CRETATECH/CRETA-WiSock/3_Document/Wisock_Design.pdf

# DETAILED DESIGN DOCUMENT

# for

# WiSocket

## Version 1.0

## Prepared by HgN

## CRETA Solution Company

## September 22, 2017

1

# Contents

1 Introduction and Goals | 3
2 Design Constrains | 4
3 Design Overview | 5
4 Environment and Dependencies | 9
5 API specification | 10
6 Unit test | 12

2

# 1 Introduction and Goals

## 1.1 Introduction

This document introduce the key idea of WiSocket. Its intended audience comprises Developers and Testers who need a rough understanding on the concepts of the module.

The document describes the component and its internal logic, lists any dependencies to external components, internal constraints and defines its APIs.

The document explains the components design in detail.

## 1.2 Goals

The main goals of this product is:

1. WiSocket can control one device via both button or app.
2. WiSocket’s WiFi can be setup easily using SmartConfig.

## 1.3 Definitions, Acronyms and Abbreviations

MQTT | Message Queuing Telemetry Transport
MAC | Media Access Controll Address

## 1.4 Referenced Document

HW Schematic | 1 Input/WiSocket Schematic.pdf
Detailed requirement | 1 Input/WiSocket Requirement.pdf

3

# 2 Design Constrains

1. Product must have a status led that show product status clearly, easy.
2. Control/Config method should be simple and convinient for non-tech user.
3. All devices and leds must be active-low.

4

# 3 Design Overview

## 3.1 Overview

1. General:
- This product has:

– 1 device which can be controlled ON/OFF via digital sysnal.

– 1 config button (push button), use polling method.

– 1 control button (switch), use interrupt.

– 1 status led.

- All devices and leds must be active-low.
- Status led can show: WiFi Connecting, WiFi Connected and WiFi Configur-ing.
- Firmware has two state: Config and Control.
- User can go in and out state Config by holding config button for about 3 seconds.
- User can control device via control button at anytime, even without internet.
2. State Config:
- Use SmartConfig to setup device’s WiFi.
- An config flag stored in EEPROM at address 0x10. This flag must be read each time start up to check WiFi configuration.

– Value 0x05: Device is already configured. Try to connect using saved SSID and password.

– Other value: Deive has no SSID and password to connect.

3. State Control:

5

- Device try to connect to WiFi and MQTT server. Always check for proper connection. Should have connection failure hanlder.
- Topic name:
Topic to subcribe | ESP+<MAC>/master
Topic to publish | ESP+<MAC>/slave
- Use protocol as in Requirement Documentation (5.3.2 Data Format) to com-municate with user’s app. There’s 2 function:

– Function Control: Control 1 device ON/OFF.

– Function Data: Get status of device.

## 3.2 Configuration

These parameters should be setup manually in firmware: MQTT server ”iot.eclipse.org”

## 3.3 File structure

WiSocket.ino
|___state.h
|___protocol.h
| |___mqtt.h
|___device.h
|___button.h

## 3.4 Critical timing constrains

- All function must have execute time within 1s to prevent ESP watchdog timer reset.

6

## 3.5 Diagram

### 3.5.1 State machine

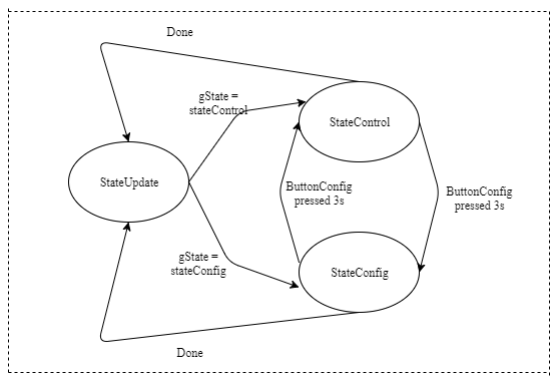
[picture p1: figure]

Figure 3.1: WiSocket’s state machine

### 3.5.2 State Config and Control

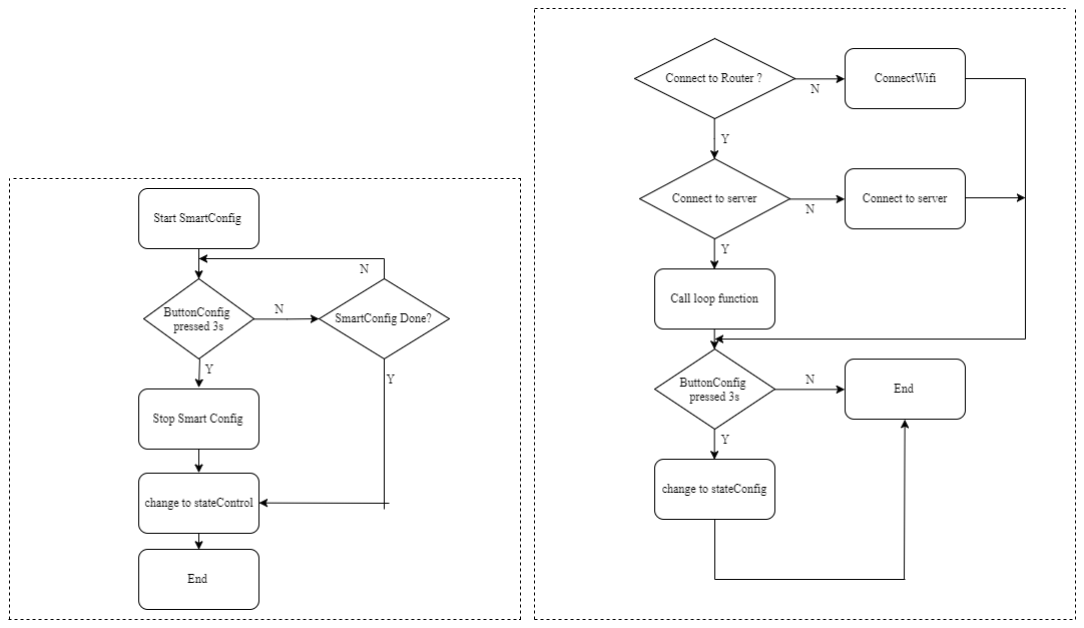
[picture p2: figure]

(a) State Config | (b) State Control

Figure 3.2: WiSocket’s state config and control

7

## 3.6 Failure handling strategy

- All conditional loops must have time out condition to prevent hanging.

8

# 4 Environment and Dependencies

## 4.1 Evironment

This project is built using Arduino IDE 1.8.4.

## 4.2 Dependencies

This project need these dependencies:

- Board packet: esp8266 by ESP8266 Community version 2.2.0.
- Library: ArduinoJson by Benoit Blanchon version 5.5.1.
- Library: PubSubClient by Nick O’Leary version 2.6.0.

9

# 5 API specification

## 5.1 Device

v oid d e v i c e I n i t ( v oid ) ;
v oid deviceOn ( v oid ) ;
v oid d e vi c e O f f ( v oid ) ;
v oid d e vi c eT o g gl e ( v oid ) ; v oid ledDeviceOn ( v oid ) ; v oid l e dD e vi c eO f f ( v oid ) ; v oid ledWi fiOn ( v oid ) ;
v oid l e dWi fi O f f ( v oid ) ;
v oid l e dWi fi T o g gl e ( v oid ) ; i n t d e vi c e S t a t u s ( v oid ) ;

## 5.2 Button

v oid b u t t o n I ni t ( v oid ) ; | [ ESP PJ 0 1 8]
v oid bu t tonCon fig ISRHandle r ( v oid ) ; | [ ESP PJ 0 2 0]
b o ol buttonCon figCheck ( v oid ) ; | [ ESP PJ 0 1 9 , 0 0 8]
b o ol buttonControlCheck ( v oid ) ; | [ ESP PJ 0 2 0]

## 5.3 MQTT

v oid c a l l b a c k ( ch a r ∗ t o pi c , byte ∗ payload , un si gned i n t l e n g t h ) ;
| [ ESP PJ 014−017]
v oid mqttCreateTopic ( v oid ) ; | [ ESP PJ 022−023]
v oid m q t tSub sc ribe ( v oid ) ; | [ ESP PJ 0 2 1]
i n t mqttConnect ( v oid ) ; | [ ESP PJ 0 2 1]
i n t mqttConnected ( v oid ) ; | [ ESP PJ 0 2 1]
v oid mq t tPublish ( S t ri n g jsonOut ) ; | [ ESP PJ 0 2 1]
v oid mqttLoop ( v oid ) ; | [ ESP PJ 0 1 3]

10

## 5.4 Protocol

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

## 5.5 State

v oid s t a t e S e t u p ( v oid ) ; | [ ESP PJ 006−007]
v oid s t a t e C o n fi g ( v oid ) ; | [ ESP PJ 0 0 5 , 033−037]
v oid s t a t e C o n t r ol ( v oid ) ; | [ ESP PJ 009−12]

11

# 6 Unit test

12
