CRETATECH/CRETA-WiSock/3_Document/WiSock_test.pdf

## TÀI LIỆU KIỂM TRA ĐÁNH GIÁ

## Dự án: WiSock

Soạn thảo: HgN + Nghia

Ngày 1 tháng 10 năm 2017

## Mục lục

1 GIỚI THIỆU | 3
2 PHƯƠNG THỨC HOẠT ĐỘNG VÀ CÁC YẾU TỐ CẦN KIỂM TRA | 4
3 Chi tiết phương thức kiểm tra đánh giá | 5
4 PHỤ LỤC | 7

1 | GIỚI THIỆU
1.1 | Giới thiệu

Tài liệu này được soạn nhằm liệt kê các công cụ và phương thức kiểm tra sản phẩm. Cụ thể tài liệu sẽ liệt kê chi tiết các trường hợp cần kiểm tra, cách thức kiểm tra và đánh giá kết quả. Đối tượng của tài liệu này là các Developer và Tester tham gia vào quá trình hoàn thiện, kiểm tra và phát triển sản phẩm.

1.2 Tổng quan sản phẩm

WiSock là sản phẩm thông minh điều khiển bật tắt một thiết bị từ xa thông qua hệ thống mạng Internet. Cụ thể thiết bị sử dụng một ESP8266 v7 kết nối bằng giao thức MQTT tới một server, thông qua đó người dùng có thể điều khiển và thu thập trạng thái thiết bị thông qua ứng dụng được cung cấp.

1.3 | Các định nghĩa và viết tắt
Định nghĩa/Viết tắt | Chi tiết
WiSock | Sử dụng để nói chung sản phẩm/bộ phận điều khiển chính của sản phẩm.
Thiết bị | Nói đến thiết bị người dùng được WiSock điều khiển bật tắt.
MQTT | Message Queuing Telemetry Transport.
Topic/Broker/Subcribe/Publish | Các thuật ngữ của giao thức MQTT.
MAC | Media Access Control address.
SSID/Password | Tên và mật khẩu kết nối WiFi.
Config | Thiết lập SSID và password cho WiSock.

Bảng 1: Bảng định nghĩa và viết tắt

2 | PHƯƠNG THỨC HOẠT ĐỘNG VÀ CÁC YẾU TỐ CẦN KIỂM TRA
2.1 | Tổng quan thiết kế
1. Sau khi khởi động, WiSock sẽ kiểm tra thông tin WiFi:
| • Nếu đã có SSID và password được lưu, WiSock sẽ sử dụng thông tin đó để kết nối WiFi. • Nếu chưa có SSID và password, nhấn nút Config sẽ chuyển sang chế độ config, sử dụng giao thức SmartConfig để cài đặt SSID và password cho WiSock/
2. Sau khi kết nối WiFi thành công, WiSock sẽ cố gắng kết nối đến broker MQTT.
3. Sau khi kết nối thành công tới broker MQTT, WiSock sẽ dựa trên MAC để tạo ra các topic:
| • Topic để Subcribe: ESP+<MAC>/master • Topic để Publish: ESP+<MAC>/slave
4. WiSock lúc này có thể nhận gói tin điều khiển từ server (gói tin theo cấu trúc JSON).
5. WiSock luôn có thể được điều khiển bằng một nút nhấn (dạng switch).
6. WiSock có thể chuyển về chế độ config để thay đổi SSID và password, cũng như chuyển từ chế độ
| config về chế độ điều khiển bằng một nút nhấn (dạng push button, giữ trong 3s).
7. WiSock có một led báo trạng thái, luôn thể hiện rõ ràng trạng thái hiện tại của WiSock (WiFi
| connecting, WiFi connected, WiFi configuring).
2.2 | Các yếu tố cần kiểm tra và đánh giá
1. Kiểm tra các yếu tố phần cứng
| • Kiểm tra led trạng thái. • Kiểm tra nút nhấn điều khiển và khả năng điều khiển thiết bị. • Kiểm tra nút nhấn config.
2. Kiểm tra kết nối
| • Kiểm tra phương thức SmartConfig. • Kiểm tra kết nối tới WiFi. • Kiểm tra kết nối tới broker MQTT.
3. Kiểm tra phương thức giao tiếp
| • Kiểm tra đáp ứng của hệ thống với từng lệnh điều khiển khác nhau.
4. Kiểm tra tính ổn định của hệ thống
| • Kiểm tra khả năng xử lý của hệ thống khi mất kết nối tới WiFi hoặc broker. • Kiểm tra khả năng xử lý của hệ thống khi gặp xự cố mất điện. • Kiểm tra tính ổn đinh/đáng tin cậy của hệ thống khi hoạt động trong thời gian dài.

3 | Chi tiết phương thức kiểm tra đánh giá
3.1 | Công cụ kiểm tra
- Kiểm tra bằng tay:
| – App SmartConfig (thiết lập SSID và password). – MQTT Lens (giao tiếp với WiSock).
- Kiểm tra tự động:
| – Script python/bash và các file log.

Ngoài ra source code của WiSock có hỗ trợ debug qua cổng Serial nên có thể thể dùng thêm 1 USB UART để hỗ trợ quá trình kiểm tra sửa lỗi.

3.2 Chi tiết kiểm tra

Các phương thức kiểm tra dưới đây nên được thực hiện theo đúng trình tự từ trên xuống dưới. Một số phướng thức kiểm tra được nêu sau có thể mặc định các bài kiểm tra trước đó đã qua (pass) và dựa vào đó để đưa ra kết luận đánh giá.

3.2.1 Kiểm tra yếu tố phần cứng

Kiểm tra

- Đảm bảo WiSock được cấp nguồn đúng chuẩn và ổn định.
- Đánh giá bằng mắt hành vi của led trạng thái, đảm bảo hành vi tương tự như trong thiết kế. Từ
| đó có thể một phần dựa vào led trạng thái để đánh giá các hành vi khác.
- Bật tắt nút điều khiển và xem trạng thái của thiết bị được điều khiển.
- Nhấn giữ nút config trong khoảng 3 giây để đổi trạng thái hoạt động của WiSock.

Kết quả mong muốn

- Hệ thống khởi động nhanh, ổn định.
- Thiết bị đổi trạng thái bật tắt theo trạng thái nút nhấn, độ trễ thấp.
- WiSock chuyển đổi giữa trạng thái config và trạng thái điều khiển dễ dàng (dựa vào led trạng thái
| để kiểm tra).
3.2.2 | Kiểm tra kết nối

Kiểm tra 1: Chuyển WiSock về chế độ config, sử dụng SmartConfig để cung cấp chính xác SSID và password.

Kết quả mong muốn 1: Led trạng thái phải báo WiSock chuyển sang đang kết nối WiFi và sau đó là kết nối thành công. Ứng dụng smart config phải nhận được MAC của WiSock.

Kiểm tra 2: Kiểm tra topic "topicTest" trên MQTT ngay sau khi WiSock đã kết nối được WiFi.

Kết quả mong muốn 2: Nếu kết nối được tới broker MQTT, WiSock sẽ gửi gói tin dạng ESP+<MAC> như một dạng thông báo tên topic.

3.2.3 Kiểm tra phương thức giao tiếp

Kiểm tra 1: Lệnh điều khiển
Gửi một trong hai frame sau tới topic mà WiSock subcribe (topic master): {ID:"ESP+<MAC>", FUNC:"Ctrl", ADDR:"1", DATA:"ON"} {ID:"ESP+<MAC>", FUNC:"Ctrl", ADDR:"1", DATA:"OFF"}

Kết quả mong muốn 1:

- Thiết bị phải được bật hoặc tắt tương ứng với lệnh gửi đi.
- Nhận được trên topic mà WiSock publish (topic slave) frame sau, ứng với trạng thái sau khi điều khiển:
{ID:"ESP+<MAC>", FUNC:"Ctrl", ADDR:"1", DATA:"ON"}
{ID:"ESP+<MAC>", FUNC:"Ctrl", ADDR:"1", DATA:"OFF"}

Kiểm tra 2: Lệnh dữ liệu
Gửi frame sau tới topic mà WiSock subcribe (topic master):
{ID:"ESP+<MAC>", FUNC:"Data", ADDR:"1", DATA:""}

Kết quả mong muốn 2: Nhận được trên topic mà WiSock publish (topic slave) frame sau, ứng với trạng thái hiện tại của thiết bị:
{ID:"ESP+<MAC>", FUNC:"Data", ADDR:"1", DATA:"ON"}
{ID:"ESP+<MAC>", FUNC:"Data", ADDR:"1", DATA:"OFF"}

Kiểm tra 3: Điều khiển nút nhấn
Nhấn nút điều khiển để đổi trạng thái thiết bị.

Kết quả mong muốn 2: Nhận được trên topic mà WiSock publish (topic slave) frame sau, ứng với trạng thái hiện tại của thiết bị:
{ID:"ESP+<MAC>", FUNC:"Data", ADDR:"1", DATA:"ON"}
{ID:"ESP+<MAC>", FUNC:"Data", ADDR:"1", DATA:"OFF"}

Kiểm tra 4: Lỗi giao tiếp
Gửi một frame sai cấu trúc JSON hoặc một frame sai các trường/dữ liệu.

Kết quả mong muốn 4: Nhận được trên topic mà WiSock publish (topic slave) frame sau, ứng với trạng thái hiện tại của thiết bị:
{ID:"ESP+<MAC>", FUNC:"Error", ADDR:"1", DATA:"ErrFrame"}

3.2.4 Kiểm tra tính ổn định của hệ thống

Kiểm tra 1: Ngắt nguồn của WiSock, sau đó cấp nguồn trở lại.

Kết quả mong muốn 1: WiSock nhanh chóng khởi động, sử dụng SSID và password đã lưu để kết nối lại mà không cần phải config lại.

Kiểm tra 2: Ngắt kết nối WiFi, sau đó bật trở lại.

Kết quả mong muốn 2: WiSock báo trạng thái mất kết nối/thử kết nối lại thông qua led trạng thái. WiSock cũng phải nhanh chóng kết nối lại ngay sau khi WiFi được hồi phục (kiểm tra giống như 3.2.2).

Kiểm tra 3: Cho WiSock chạy trong thời gian dài. Trong thời gian đó liên tục gửi các gói lệnh tới WiSock để kiểm tra khả năng đáp ứng.

Kết quả mong muốn 3: WiSock hoạt động ổn định, không gặp tình trạng tự reset, ngắt kết nối, treo cứng ngưng hoạt động. Số gói tin gửi nhận thành công trên 90%.

4 | PHỤ LỤC
4.1 | Tài liệu tham khảo
Tài liệu | Nguồn
Requirement | 1_Requirement/WiSock_Requirement.pdf
HW Schematic | 1_Requirement/WiSock_Schematic.pdf
Design document | 3_Documentation/WiSock_Design.pdf

Bảng 2: Các tài liệu tham khảo

4.2 Bảng trạng thái led

Chèn hộ cái bảng vào đây
