CRETATECH/CRETA-WiSock/1_Requirement/WiSocket_Schematic.pdf

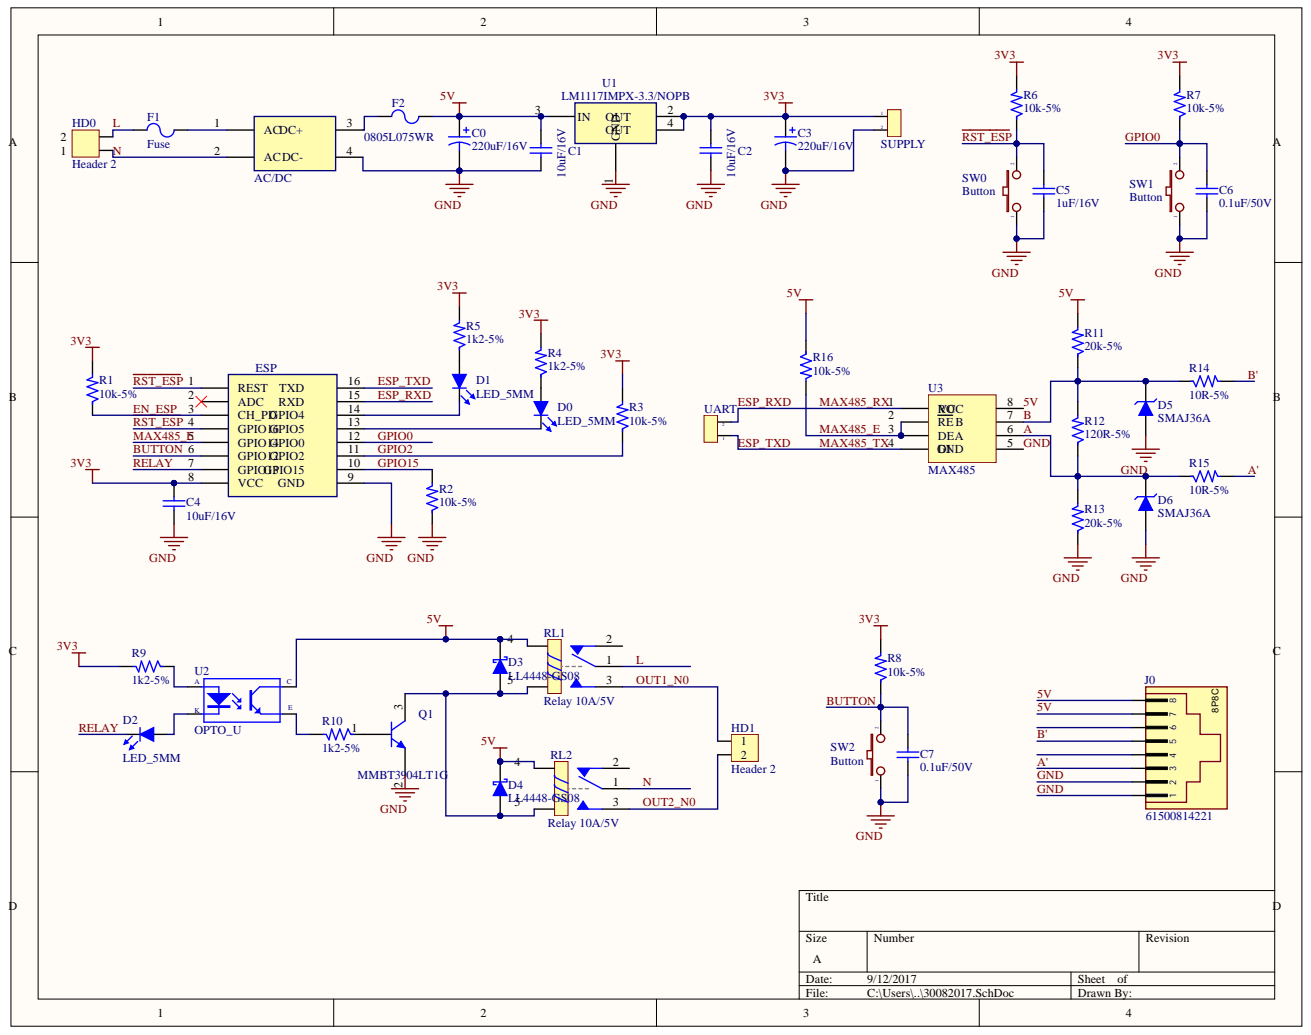
[picture p6: page 1]

2 | MAX485_E | DE 3 | A
ESP_TXD MAX485_TX
