CRETATECH/CRETA-WiSock/2_Workspace/wishock/button.cpp

/***************************************************************************************
* INCLUDE
***************************************************************************************/
#include <ESP8266WiFi.h>
#include "button.h"
#include "device.h"
#include "mqtt.h"
#include "protocol.h"

/***************************************************************************************
* LOCAL VARIABLES
***************************************************************************************/
uint8_t _button_status;
/***************************************************************************************
* EXTERN VARIABLES
***************************************************************************************/
bool isButtonPressed = false;
/***************************************************************************************
* PUBLIC FUNCTION
***************************************************************************************/
/**
 * @brief       Init all button
 * @param       None
 */
void buttonInit(void){
    pinMode(PIN_BUTTON_CONFIG, INPUT_PULLUP);
    /* set Interrupt for BUTTON_CONFIG */
    attachInterrupt(digitalPinToInterrupt(PIN_BUTTON_CONTROL), buttonConfigISRHandler, CHANGE);
    pinMode(PIN_BUTTON_CONTROL, INPUT);
    _button_status = digitalRead(PIN_BUTTON_CONTROL);
}
/**
 * @brief       Button IRS Handler
 * @param       None
 * process interrupt, change device state and set flag to network process
 */
void buttonConfigISRHandler(void){
    static uint32_t _button_last_pressed = 0;
    uint16_t _timeout = 0xFF;
    while(_timeout) {
        _timeout--;
        Serial.println(_timeout);
    }
    if(digitalRead(PIN_BUTTON_CONTROL) != _button_status) {
        isButtonPressed = true; //varialbe return to network process
        #ifdef DEBUG
          Serial.println("Control button pressed");
        #endif
        deviceToggle(); // change state of device
        _button_status = digitalRead(PIN_BUTTON_CONTROL);
    }
}
/**
 * @brief       Button config check
 * @param       None
 * @retval      true
 *              false
 */
bool buttonConfigCheck(void){
    static uint8_t buttonLastStatus = HIGH;
    static uint32_t buttonLastPressed = 0;
    uint8_t buttonStatus = digitalRead(PIN_BUTTON_CONFIG);
    if(buttonStatus != buttonLastStatus){
        if(buttonStatus == LOW){
            buttonLastPressed = millis();
        }
    }
    else{
        if(buttonStatus == LOW){
            if((millis() - buttonLastPressed) > 3000){
                return true;
            }
        }
    }
    buttonLastStatus = buttonStatus;
    return false;
    
    
}

bool buttonControlCheck(void){
    if(isButtonPressed == true){
        isButtonPressed = false;
        return true;
    }
    return false;
}
