CRETATECH/CRETA-WiSock/(commit log)

2017-09-11 Add button config
2017-09-11 Add button device
2017-09-12 Remove 2 trunk folder. Add deviceStatus function.
2017-09-12 Add Schematic
2017-09-12 da code xong process va respond, chua test, mai qua can cu test, h di ngu
2017-09-13 rename variable of all module (except button)
2017-09-14 Fix button
2017-09-14 button fixed (tested)
2017-09-14 Status led done
2017-09-15 Fix some bug: + WiFi mode STA.
    [mqtt.cpp, state.cpp]
2017-10-13 them hanh vi led trong trang thai Config
2017-10-13 fix led status
2017-10-13 publish ESP+macID khi reset
    [mqtt.cpp]
2017-10-13 fix wisock (little) and add func_test.py (nguyen write)
    [button.cpp, mqtt.cpp, protocol.cpp, state.cpp]
2017-10-22 Merge develop to master branch (#8)
    * Clean (#6)
    Fix small error and tested:
    * Fix button error.
    * Script test and manual test ok.
    * Finish performance test script (#7)
    [button.cpp, protocol.cpp]
2017-10-29 Fix Smart config and Protocol bug (wrong status) (#9)
    * fix smartconfig bug (auto doneSmartConfig)
    * fix protocol, now get function and excute in protocolCtrlFuncProc and protocolDataFuncProc
    * bring Serial.prinln debug to ifdef
    [button.cpp, protocol.cpp, state.cpp]
2017-10-30 Develop (#14)
    * Fix Smart config and Protocol bug (wrong status) (#9)
    * Add control app for WiSock quick test (#10)
    * Fix protocolButtonProc (#12)
    * Fix button error made by relay
    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
    [button.cpp, protocol.cpp]
2017-11-13 Merge và xóa branch develop.
    * Finish test script.
    * FixProtocol bug (wrong status).
    * Fix SmartConfig bug (auto pass SmartConfig done).
    * Fix protocol, now get function and excute in protocolCtrlFuncProc and protocolDataFuncProc.
    * Bring all Serial.prinln() debug to ifdef.
    * Add control app for WiSock quick test.
    * Fix protocolButtonProc.
    * Fix reset error of control button.
    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
    [button.cpp]
